ColinNg/dscKeybusInterface/extras/PCB Layouts/ESP/ESP-01/DSC-ESP-01/DSC-ESP-01.kicad_pcb

## KiCad design extras/PCB Layouts/ESP/ESP-01/DSC-ESP-01/DSC-ESP-01.kicad_pcb (2025-10-08)

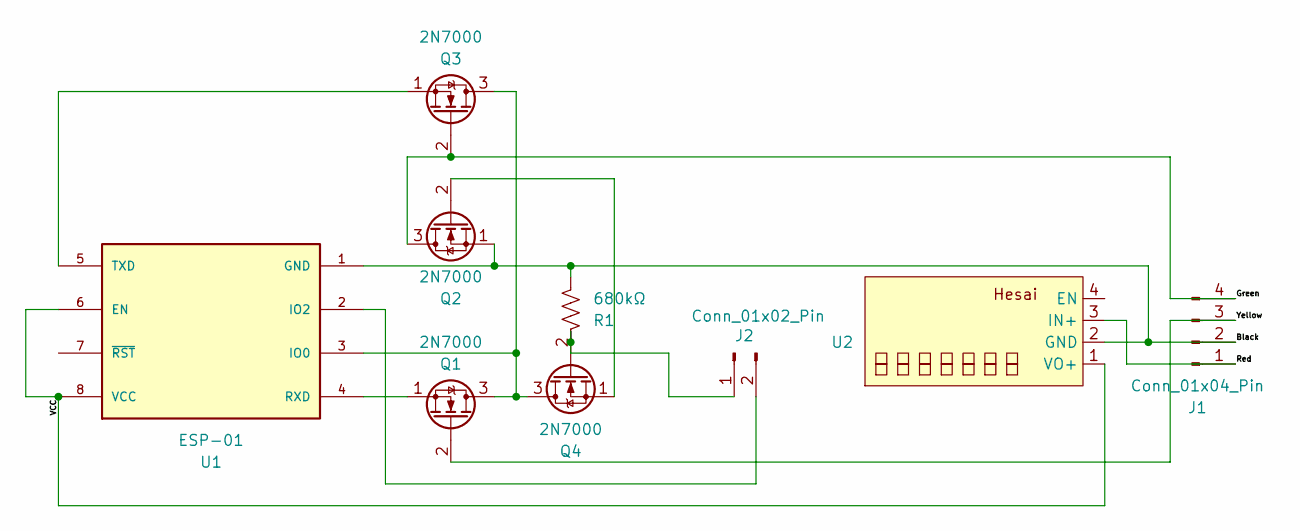
[picture p1: schematic DSC-ESP-01.kicad_sch]

Parts:
J1: Conn_01x04_Pin; JST_XH_B4B-XH-A_1x04_P2.50mm_Vertical
J2: Conn_01x02_Pin; PinHeader_1x02_P2.54mm_Horizontal
Q1, Q2, Q3, Q4: 2N7000; TO-92_Inline
R1: 680kΩ; R_Axial_DIN0204_L3.6mm_D1.6mm_P5.08mm_Horizontal
U1: ESP-01; ESP-01 No Keepout; PARTREV V1.2
U2: Converter_DCDC_Hesai_Mini

Connections:
/Black: J1.2, Q2.1 (S), R1.2, U1.1 (GND), U2.2 (GND)
/Green: J1.4, Q2.3 (D), Q3.2 (G)
/Red: J1.1, U2.3 (IN+)
/VCC: U1.6 (EN), U1.8 (VCC), U2.1 (VO+)
/Yellow: J1.3, Q1.2 (G)
unnamed: J2.1, Q4.2 (G), R1.1
unnamed: J2.2, U1.2 (IO2)
unnamed: Q1.3 (D), Q3.3 (D), Q4.3 (D), U1.3 (IO0)
unnamed: Q1.1 (S), U1.4 (RXD)
unnamed: Q2.2 (G), Q4.1 (S)
unnamed: Q3.1 (S), U1.5 (TXD)

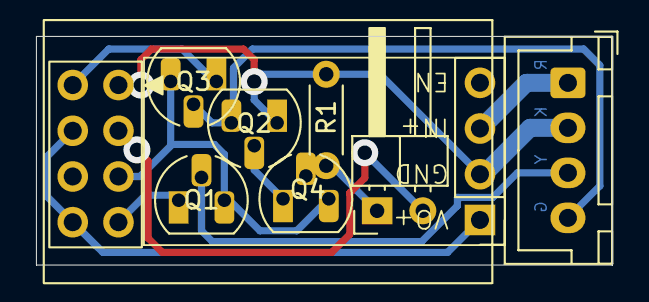
[picture p2: board DSC-ESP-01.kicad_pcb from above]

Board: 2 copper layers, 32.0 x 12.7 mm, 9 parts (0 on the bottom side), 11 nets.
