ColinNg/dscKeybusInterface/(commit log)

2018-08-18 Moved secrets to Secrets.h. Comment about a connected but unused Write pin causing problems.
    [Twilio.ino]
2018-08-19 Sending Arm/Disarm status over Twilio. Also echoing status over serial.
2018-08-19 Fixed compilation issues. Added a string to flash.
    [Twilio.ino]
2019-12-02 Moved sendPush, appendPartition, and printTimestamp to be before setup, because the Arduino 1.9.0-beta (needed for macOS Catalina compatibility) fails to compile otherwise.
    [Twilio-SMS.ino]
2022-01-22 Found out the HIGH on startup caused the input transistors to "listen" and thus cause other pins to go HIGH, crashing on startup. Switched the enableTransistorsPin to one that defauls to LOW on boot,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
    [Twilio-SMS.ino]
2025-10-01 Initial commit of DSC-ESP-01 PCB design in KiCAD.
    [DSC-ESP-01.kicad_pcb, DSC-ESP-01.kicad_sch]
2025-10-01 DSC-ESP-01 PCB Gerbers and Excellon Drill Files generated by KiCAD.
    [DSC-ESP-01-B_Cu.gbr, DSC-ESP-01-B_Mask.gbr, DSC-ESP-01-B_Paste.gbr, DSC-ESP-01-B_Silkscreen.gbr, DSC-ESP-01-Edge_Cuts.gbr, DSC-ESP-01-F_Cu.gbr, DSC-ESP-01-F_Mask.gbr, DSC-ESP-01-F_Paste.gbr]
2025-10-02 Moved traces to allow milling with a wider (or dull) bit. Changed ESP-01 landing holes to 1.0mm, and standardized other holes.
    [DSC-ESP-01.kicad_pcb]
2025-10-08 Redesigned DSC-ESP-01.kicad_pcb to use the `TO-92_HandSolder` footprint.
    [DSC-ESP-01.kicad_pcb]
